matsstaff/AmigaResetSwitch/img/74LS38N_3.jpg

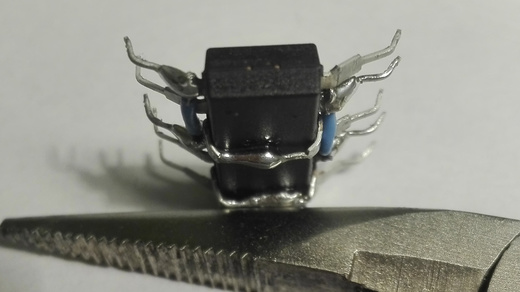
img/74LS38N_3.jpg
